crashmaxx/VoronUsers/printer_mods/Badnoob/AB-BN/STL_files/AB-BN-30_two-part/Fan Front Bottom.stl

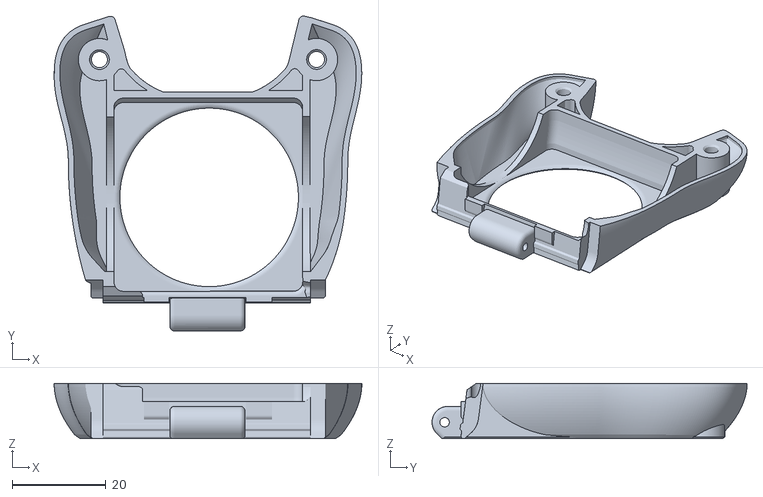
[picture p2: CAD file, 2021-09-12]
printer_mods/Badnoob/AB-BN/STL_files/AB-BN-30_two-part/Fan Front Bottom.stl
65.5 x 67.1 x 11.8
