crashmaxx/VoronUsers/printer_mods/Badnoob/AB-BN/STL_files/AB-BN-30_two-part/Mosquito Back Modified.stl

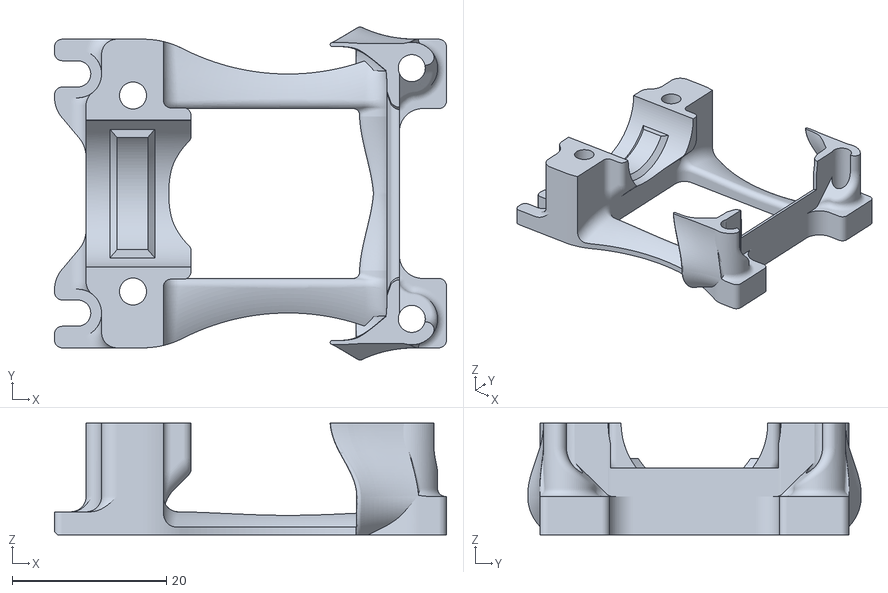
[picture p3: CAD file, 2021-09-12]
printer_mods/Badnoob/AB-BN/STL_files/AB-BN-30_two-part/Mosquito Back Modified.stl
50.8 x 43.2 x 14.5
