crashmaxx/VoronUsers/(commit log)

2021-09-12 Added hinged version
    Added hinged versions by Anogar V1.150 V2.081 (Anogar#1290), see AB-BN-30_two-part.f3d and STL files in AB-BN-30_two-part folder
    [Fan Front Bottom.stl, Mosquito Back Modified.stl]
2021-10-29 Added Mosquito CAD Model
    Add a STEP file of the Mosquito in addition to the f3d
